janual57/__Controlador_Remoto_Bomba_Agua/README.md

# __Controlador_WiFi_Bomba_Agua
 Controlador WiFi Bomba Agua
