janual57/__Controlador_Remoto_Bomba_Agua/BOM_Bomba_Agua_V001.ods

Total (€) | 200,66
 | MPN | Model | Fabricante | Proveedor | Enlace | Precio | Cantidad | Descripción
 | B07JX7HJQT | Hilitand2nsdc0gh6w-02 | Hilitand | www.amazon.nl | https://www.amazon.nl/Luchtvaartstekker-IP68-SP13-luchtvaartstekker-waterdicht/dp/B07JX7HJQT | 7,94 | 3 | Luchtvaartstekker IP68 SP13 2 Pin / 3 Pin / 4 Pin / 5 Pin / 6 Pin / 7 Pin / 9 Pin plug luchtvaartstekker waterdicht (3pin)
 | B0822QV8HK | HD44780 2004 LCD-Display 4x20 | AZDelivery | www.amazon.nl | https://www.amazon.nl/AZDelivery-HD44780-2004-LCD-Display-compatibel/dp/B0822QV8HK | 5,99 | 1 | AZDelivery HD44780 2004 LCD-Display 4x20 Tekens Blauw compatibel met Arduino Inclusief E-Book!
 | B074CB1N7Z | DEN-3525 | Bluelover | www.amazon.nl | https://www.amazon.nl/gp/product/B074CB1N7Z/ref=ppx_yo_dt_b_asin_title_o01_s00?ie=UTF8&psc=1 | 8,99 | 1 | Bluelover Ac-Dc Geïsoleerd Ac 110V/220V naar DC 5V 600mA constante spanningsschakelaar voedingsmodule
 | B0C7GJX239 | F4-3537513 | Flintronic®-de | www.amazon.nl | https://www.amazon.nl/flintronic-adereindhulzen-knijpverbinders-isolatiehulzen-kabelconnectoren/dp/B0C7GJX239 | 10,5 | 1 | flintronic Set adereindhulzen, 1500 stuks kabelschoenen, platte steekhulzen, knijpverbinders, isolatiehulzen, platte stekker, ring, vork, kabelschoenen, aderhulzenbox, kabelconnectoren voor
 | B0B5K2CFDG | DE-5-012-XJH-MA | Newoutset | www.amazon.nl | https://www.amazon.nl/gp/product/B0B5K2CFDG/ref=ppx_yo_dt_b_asin_title_o08_s00?ie=UTF8&psc=1 | 6,88 | 1 | O-ringen, afdichtingsringen, van rubber, assortimentsset, platte afdichtingsset, zwart, voor elektrische hydraulica, sanitair, 24 maten, 360 stuks
 | B097LJBG4K | frUJIA-002-005a | UJIAMY | www.amazon.nl | https://www.amazon.nl/gp/product/B097LJBG4K/ref=ppx_yo_dt_b_asin_title_o03_s00?ie=UTF8&psc=1 | 7,99 | 1 | M2 M2.5 M3 Micro Schroefassortiment Platte Ronde Kruiskopschroeven, Laptop PC Computer HDD M.2 SSD Reparatieschroevenkit - 450 Stuks, met Schroevendraaier
 | B0BJK8F7MB | 22pvc-8m | HuLuWa | www.amazon.nl | https://www.amazon.nl/gp/product/B0BJK8F7MB/ref=ppx_yo_dt_b_asin_title_o00_s00?ie=UTF8&th=1 | 22,99 | 1 | Elektriciteitsdraad,PVC elektrische draadkabel 0,34mm²22 AWG(6 kleuren 8M elk),Gestrande Draad Vertinde koperen,voor DIY Lampen Huishoudapparaten Meetapparatuur enz
 | B07XQSBW7Q | AK3-AT1-GL-M-X | Gebildet | www.amazon.nl | https://www.amazon.nl/gp/product/B07XQSBW7Q/ref=ppx_yo_dt_b_asin_title_o02_s00?ie=UTF8&th=1 | 8,99 | 1 | Gebildet 12pcs 12mm Waterdichte Kortstondige Drukknop SPST AAN/UIT 3A/3V-5V-9V-12V-24V-230VAC,Momentary Mini Ronde Drukknop voor Autotrompet, PC,Tafellamp,Huisdeurbel
 | B07SK1YRMC | HA1420M | BE-TOOL | www.amazon.nl | https://www.amazon.nl/gp/product/B07SK1YRMC/ref=ppx_yo_dt_b_asin_title_o04_s00?ie=UTF8&th=1 | 18,78 | 1 | SenRise IP65 waterdichte aftakdoos ABS elektrische projectbehuizing maat 27, wit
 | B098PZQ584 | HR-375P | HUAREW | www.amazon.nl | https://www.amazon.nl/gp/product/B098PZQ584/ref=ppx_yo_dt_b_asin_title_o05_s00?ie=UTF8&psc=1 | 6,99 | 1 | HUAREW 3 Waarden 375 Pcs 2.8/4.8/6.3mm Mannelijke en Vrouwelijke Draad Spade Connecto Crimp Terminal Isolerende Mouw Kit voor Car Audio Speaker Elektrische Bedrading
 | B071FYWZHZ | 221-413 | Wago | www.amazon.nl | https://www.amazon.nl/gp/product/B071FYWZHZ/ref=ppx_yo_dt_b_asin_title_o07_s00?ie=UTF8&psc=1 | 7,7 | 1 | 10 x Wago klem 221-413 32A 450V aansluitterminal 3-polig met hendel
 | B07NK8HJ2D | ‎ 221-415 | Wago | www.amazon.nl | https://www.amazon.nl/verbindingsklem-geleiders-bedieningshendel-ontwerp-transparant/dp/B07NK8HJ2D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 | 8,75 | 1 | Wago 10 stuks Wago 221415 verbindingsklem 5 geleiders met bedieningshendel 024 m² klein ontwerp transparant
 | B082ZLYRRN | ‎YE00259D151 | YIXISI | www.amazon.nl | https://www.amazon.nl/gp/product/B082ZLYRRN/ref=ppx_yo_dt_b_asin_title_o07_s05?ie=UTF8&th=1 | 8,99 | 1 | YIXISI 460 Stks 2.54 mm JST-XH 2/3/4/5/6 Pins Behuizing Connector Adapter Plug (JST Connector Kit)
 | B08779QH55 | ‎HR-PTM12-60P | HUAREW | www.amazon.nl | https://www.amazon.nl/gp/product/B08779QH55/ref=ppx_yo_dt_b_asin_title_o01_s00?ie=UTF8&psc=1 | 12,99 | 1 | HUAREW 12 waarden 60 stuks 3296 W multi turn trimmer potentiometer 100-500 K ohm blauw 3296 top aanpassing variabele weerstand classification kit
 | B0754N794H | AZDelivery D1 Mini | ‎AZDelivery | www.amazon.nl | https://www.amazon.nl/gp/product/B0754N794H/ref=ppx_yo_dt_b_asin_title_o05_s00?ie=UTF8&th=1 | 13,99 | 1 | AZDelivery 3 x D1 Mini NodeMcu met ESP8266-12F WLAN-Module CH340G Lua compatibel met Arduino Inclusief E-Book!
 | B07TYGBN7C | AZDelivery | AZDelivery | www.amazon.es | https://www.amazon.es/gp/product/B07TYGBN7C/ref=ppx_yo_dt_b_asin_title_o02_s00?ie=UTF8&th=1 | 9,99 | 1 | AZDelivery 5 x 1 Canal KF-301 Modulo Relay 5V Low-Level-Trigger compatibile con Arduino con E-Book Incluido!
 | B09SL1X41D | AKN-1/8W-Widerstand | AUKENIEN | www.amazon.es | https://www.amazon.es/AUKENIEN-Resistencias-Electronica-Resistencia-Resistores/dp/B09SL1X41D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 | 9,99 | 1 | AUKENIEN 1/8W Resistencias Electronica 40 Valores 400 piezas Kit Resistencia 0 a 10M Ohm Película Metálica Resistores Cumple RoHS Con Tolerancia ± 1% Resistor
 | B07VB25GS5 | XF0058X5 | ANGEEK | www.amazon.es | https://www.amazon.es/ANGEEK-DS18B20-Temperatura-TO92-55%C2%B0C-Raspberry/dp/B07VB25GS5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 | 7,49 | 1 | ANGEEK DS18B20 - Sensor de temperatura digital TO92-55 °C - +125 °C para Arduino, Raspberry Pi (5 unidades)
 |  | LB22C | LANBOO | www.aliexpress.com | https://nl.aliexpress.com/item/33055445497.html?srcSns=sns_Copy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 | 5,29 | 1 | Langoo 12V 24V 220V 15a Hoge Stroom Ip67 Kan Worden Aangepast. Momentsluiting Drukknopschakelaar
 | 296-8343-5-ND | 296-8343-5-ND | Texas Instruments | www.digikey.com | https://www.digikey.com/en/products/detail/SN74HC594N/296-8343-5-ND/376753?curr=usd | 1,3 | 1 | IC 8-BIT SHIFT REGISTER 16-DIP
 |  | BC547 | Varios | www.tinytronics.nl | https://www.tinytronics.nl/nl/componenten/transistoren/npn-transistor-bc547 | 0,15 | 3 | NPN Transistor BC547
 | B07XXXNH9V | XF0236X20 | ANGEEK | www.amazon.nl | https://www.amazon.nl/ANGEEK-mannelijke-vrouwelijke-broodplank-Raspberry/dp/B07XXXNH9V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 | 6,99 | 1 | ANGEEK 40 stuks 2,54 mm 40 pin header mannelijke en vrouwelijke PCB header broodplank voor Arduino Raspberry Pi Shield
 |  |  |  | www.aliexpress.com | https://nl.aliexpress.com/item/1005001514058091.html?scm_id=1007.40050.354490.0&scm-url=1007.40050.354490.0 | 1 | 1 | 10 stuks 2.54mm enkele rij mannelijke 1x40p afgescheiden pcb board pin header lang 11/15/17/19/21/25mm connector strip pinheader voor arduino
