janual57/__Controlador_Remoto_Bomba_Agua/FreeCAD/Base_Caja_Bomba_Agua/Base_Caja_Bomba_Agua.FCStd

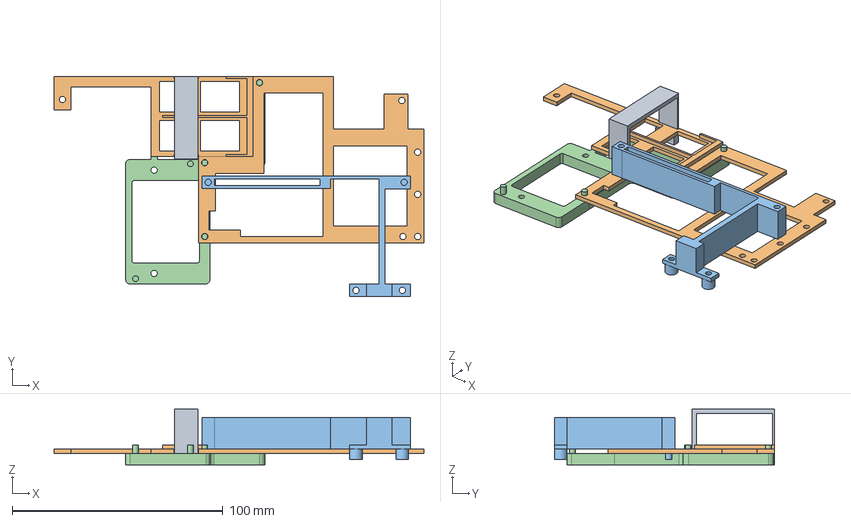
[picture p1: CAD file, 2024-05-11]
FreeCAD/Base_Caja_Bomba_Agua/Base_Caja_Bomba_Agua.FCStd
175.5 x 104.5 x 26.5 mm
