janual57/__Controlador_Remoto_Bomba_Agua/KiCAD/993_BombaAguaBase_DC/993_BombaAguaBase_DC.kicad_pcb

## KiCad design KiCAD/993_BombaAguaBase_DC/993_BombaAguaBase_DC.kicad_pcb (2024-05-11)

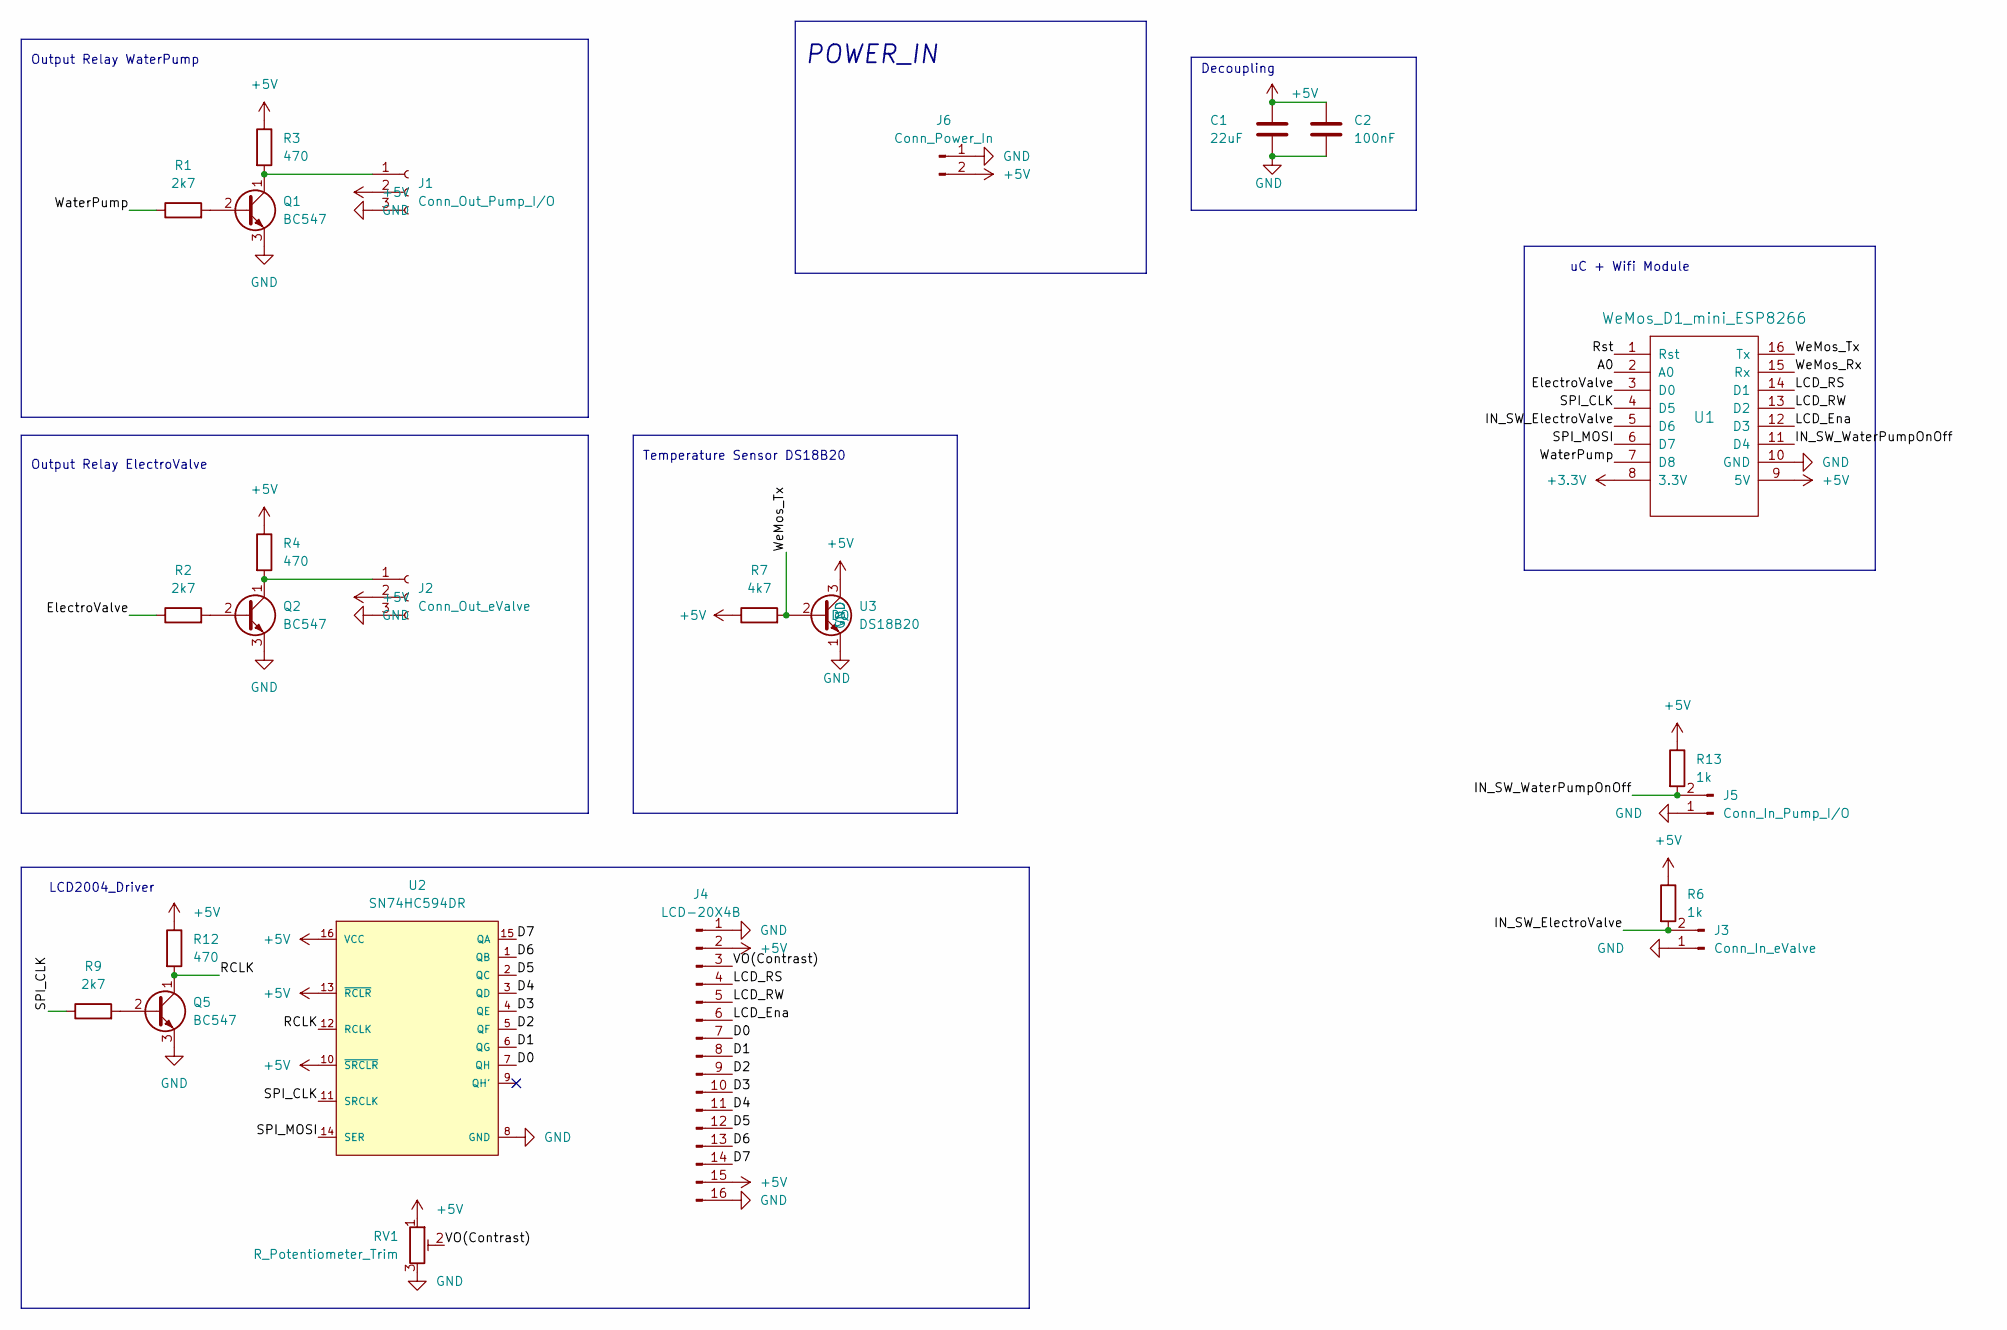
[picture p2: schematic 993_BombaAguaBase_DC.kicad_sch, Controlador Wifi de bomba de agua]

Parts:
C1: 22uF; CP_Radial_D10.0mm_P2.50mm
C2: 100nF; C_Disc_D3.8mm_W2.6mm_P2.50mm
J1: Conn_Out_Pump_I/O; JST_EH_B3B-EH-A_1x03_P2.50mm_Vertical
J2: Conn_Out_eValve; JST_EH_B3B-EH-A_1x03_P2.50mm_Vertical
J3: Conn_In_eValve; JST_EH_B2B-EH-A_1x02_P2.50mm_Vertical
J4: LCD-20X4B; PinHeader_1x16_P2.54mm_Vertical
J5: Conn_In_Pump_I/O; JST_EH_B2B-EH-A_1x02_P2.50mm_Vertical
J6: Conn_Power_In; JST_EH_B2B-EH-A_1x02_P2.50mm_Vertical
Q1, Q2, Q5: BC547; TO-92_Inline_Wide
R1, R2, R9: 2k7; R_Axial_DIN0207_L6.3mm_D2.5mm_P7.62mm_Horizontal
R3, R4, R12: 470; R_Axial_DIN0207_L6.3mm_D2.5mm_P7.62mm_Horizontal
R6, R13: 1k; R_Axial_DIN0207_L6.3mm_D2.5mm_P7.62mm_Horizontal
R7: 4k7; R_Axial_DIN0207_L6.3mm_D2.5mm_P7.62mm_Horizontal
RV1: R_Potentiometer_Trim; Potentiometer_Bourns_3296W_Vertical
U1: WeMos_D1_mini_ESP8266; D1_mini_board
U2: SN74HC594DR; DIP-16_W7.62mm; mouser part number 595-SN74HC594DR; digikey description IC SHIFT REGISTER 8BIT 16-SOIC
U3: DS18B20; TO-92_Inline_Wide

Connections:
+3.3V: U1.8 (3.3V)
+5V: C1.1, C2.1, J1.2, J2.2, J4.2, J4.15, J6.2, R3.1, R4.1, R6.1, R7.1, R12.1, R13.1, RV1.1, U1.9 (5V), U2.10 (~SRCLR), U2.13 (~RCLR), U2.16 (VCC), U3.3 (VDD)
/A0: U1.2 (A0)
/D0: J4.7, U2.7 (QH)
/D1: J4.8, U2.6 (QG)
/D2: J4.9, U2.5 (QF)
/D3: J4.10, U2.4 (QE)
/D4: J4.11, U2.3 (QD)
/D5: J4.12, U2.2 (QC)
/D6: J4.13, U2.1 (QB)
/D7: J4.14, U2.15 (QA)
/ElectroValve: R2.1, U1.3 (D0)
/IN_SW_ElectroValve: J3.2, R6.2, U1.5 (D6)
/IN_SW_WaterPumpOnOff: J5.2, R13.2, U1.11 (D4)
/LCD_Ena: J4.6, U1.12 (D3)
/LCD_RS: J4.4, U1.14 (D1)
/LCD_RW: J4.5, U1.13 (D2)
/RCLK: Q5.1 (C), R12.2, U2.12 (RCLK)
/Rst: U1.1 (Rst)
/SPI_CLK: R9.1, U1.4 (D5), U2.11 (SRCLK)
/SPI_MOSI: U1.6 (D7), U2.14 (SER)
/VO(Contrast): J4.3, RV1.2
/WaterPump: R1.1, U1.7 (D8)
/WeMos_Rx: U1.15 (Rx)
/WeMos_Tx: R7.2, U1.16 (Rx), U3.2 (DQ)
GND: C1.2, C2.2, J1.3, J2.3, J3.1, J4.1, J4.16, J5.1, J6.1, Q1.3 (E), Q2.3 (E), Q5.3 (E), RV1.3, U1.10 (GND), U2.8 (GND), U3.1 (GND)
unnamed: J1.1, Q1.1 (C), R3.2
unnamed: J2.1, Q2.1 (C), R4.2
unnamed: Q1.2 (B), R1.2
unnamed: Q2.2 (B), R2.2
unnamed: Q5.2 (B), R9.2

Notes on the sheet:
LCD2004_Driver
Decoupling
POWER_IN
Temperature Sensor DS18B20
Output Relay WaterPump
uC + Wifi Module
Output Relay ElectroValve

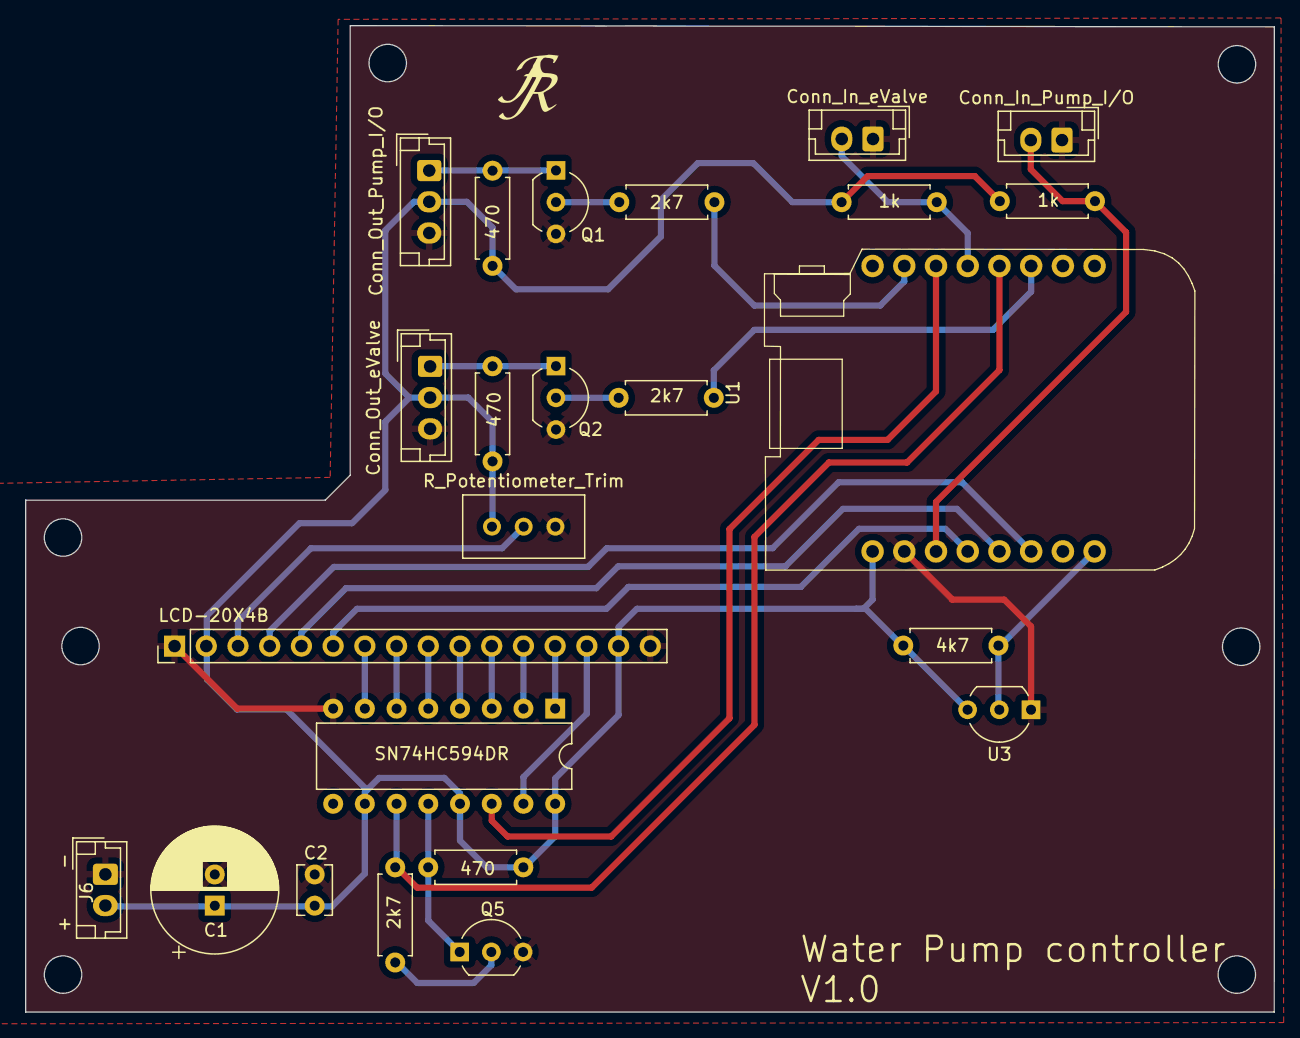
[picture p3: board 993_BombaAguaBase_DC.kicad_pcb from above]

Board: 2 copper layers, 100.0 x 79.0 mm, 24 parts (0 on the bottom side), 27 nets.
