janual57/__Controlador_Remoto_Bomba_Agua/(commit log)

2024-05-11 Initial Commit
    Upload of
    Media
    BOM
    Arduino
    FreeCAD
    KiCAD
    [993_BombaAguaBase_DC.kicad_pcb, 993_BombaAguaBase_DC.kicad_sch, BOM_Bomba_Agua_V001.ods, Base_Caja_Bomba_Agua.FCStd]
2024-07-06 Timer added
    Added Timer (ms) to auto stop (from Power On to Power Off)
